halfgaar/BBBAudioDecoderCircuits/bbb_audio_decoder.brd

## EAGLE design bbb_audio_decoder.brd (2020-10-24)

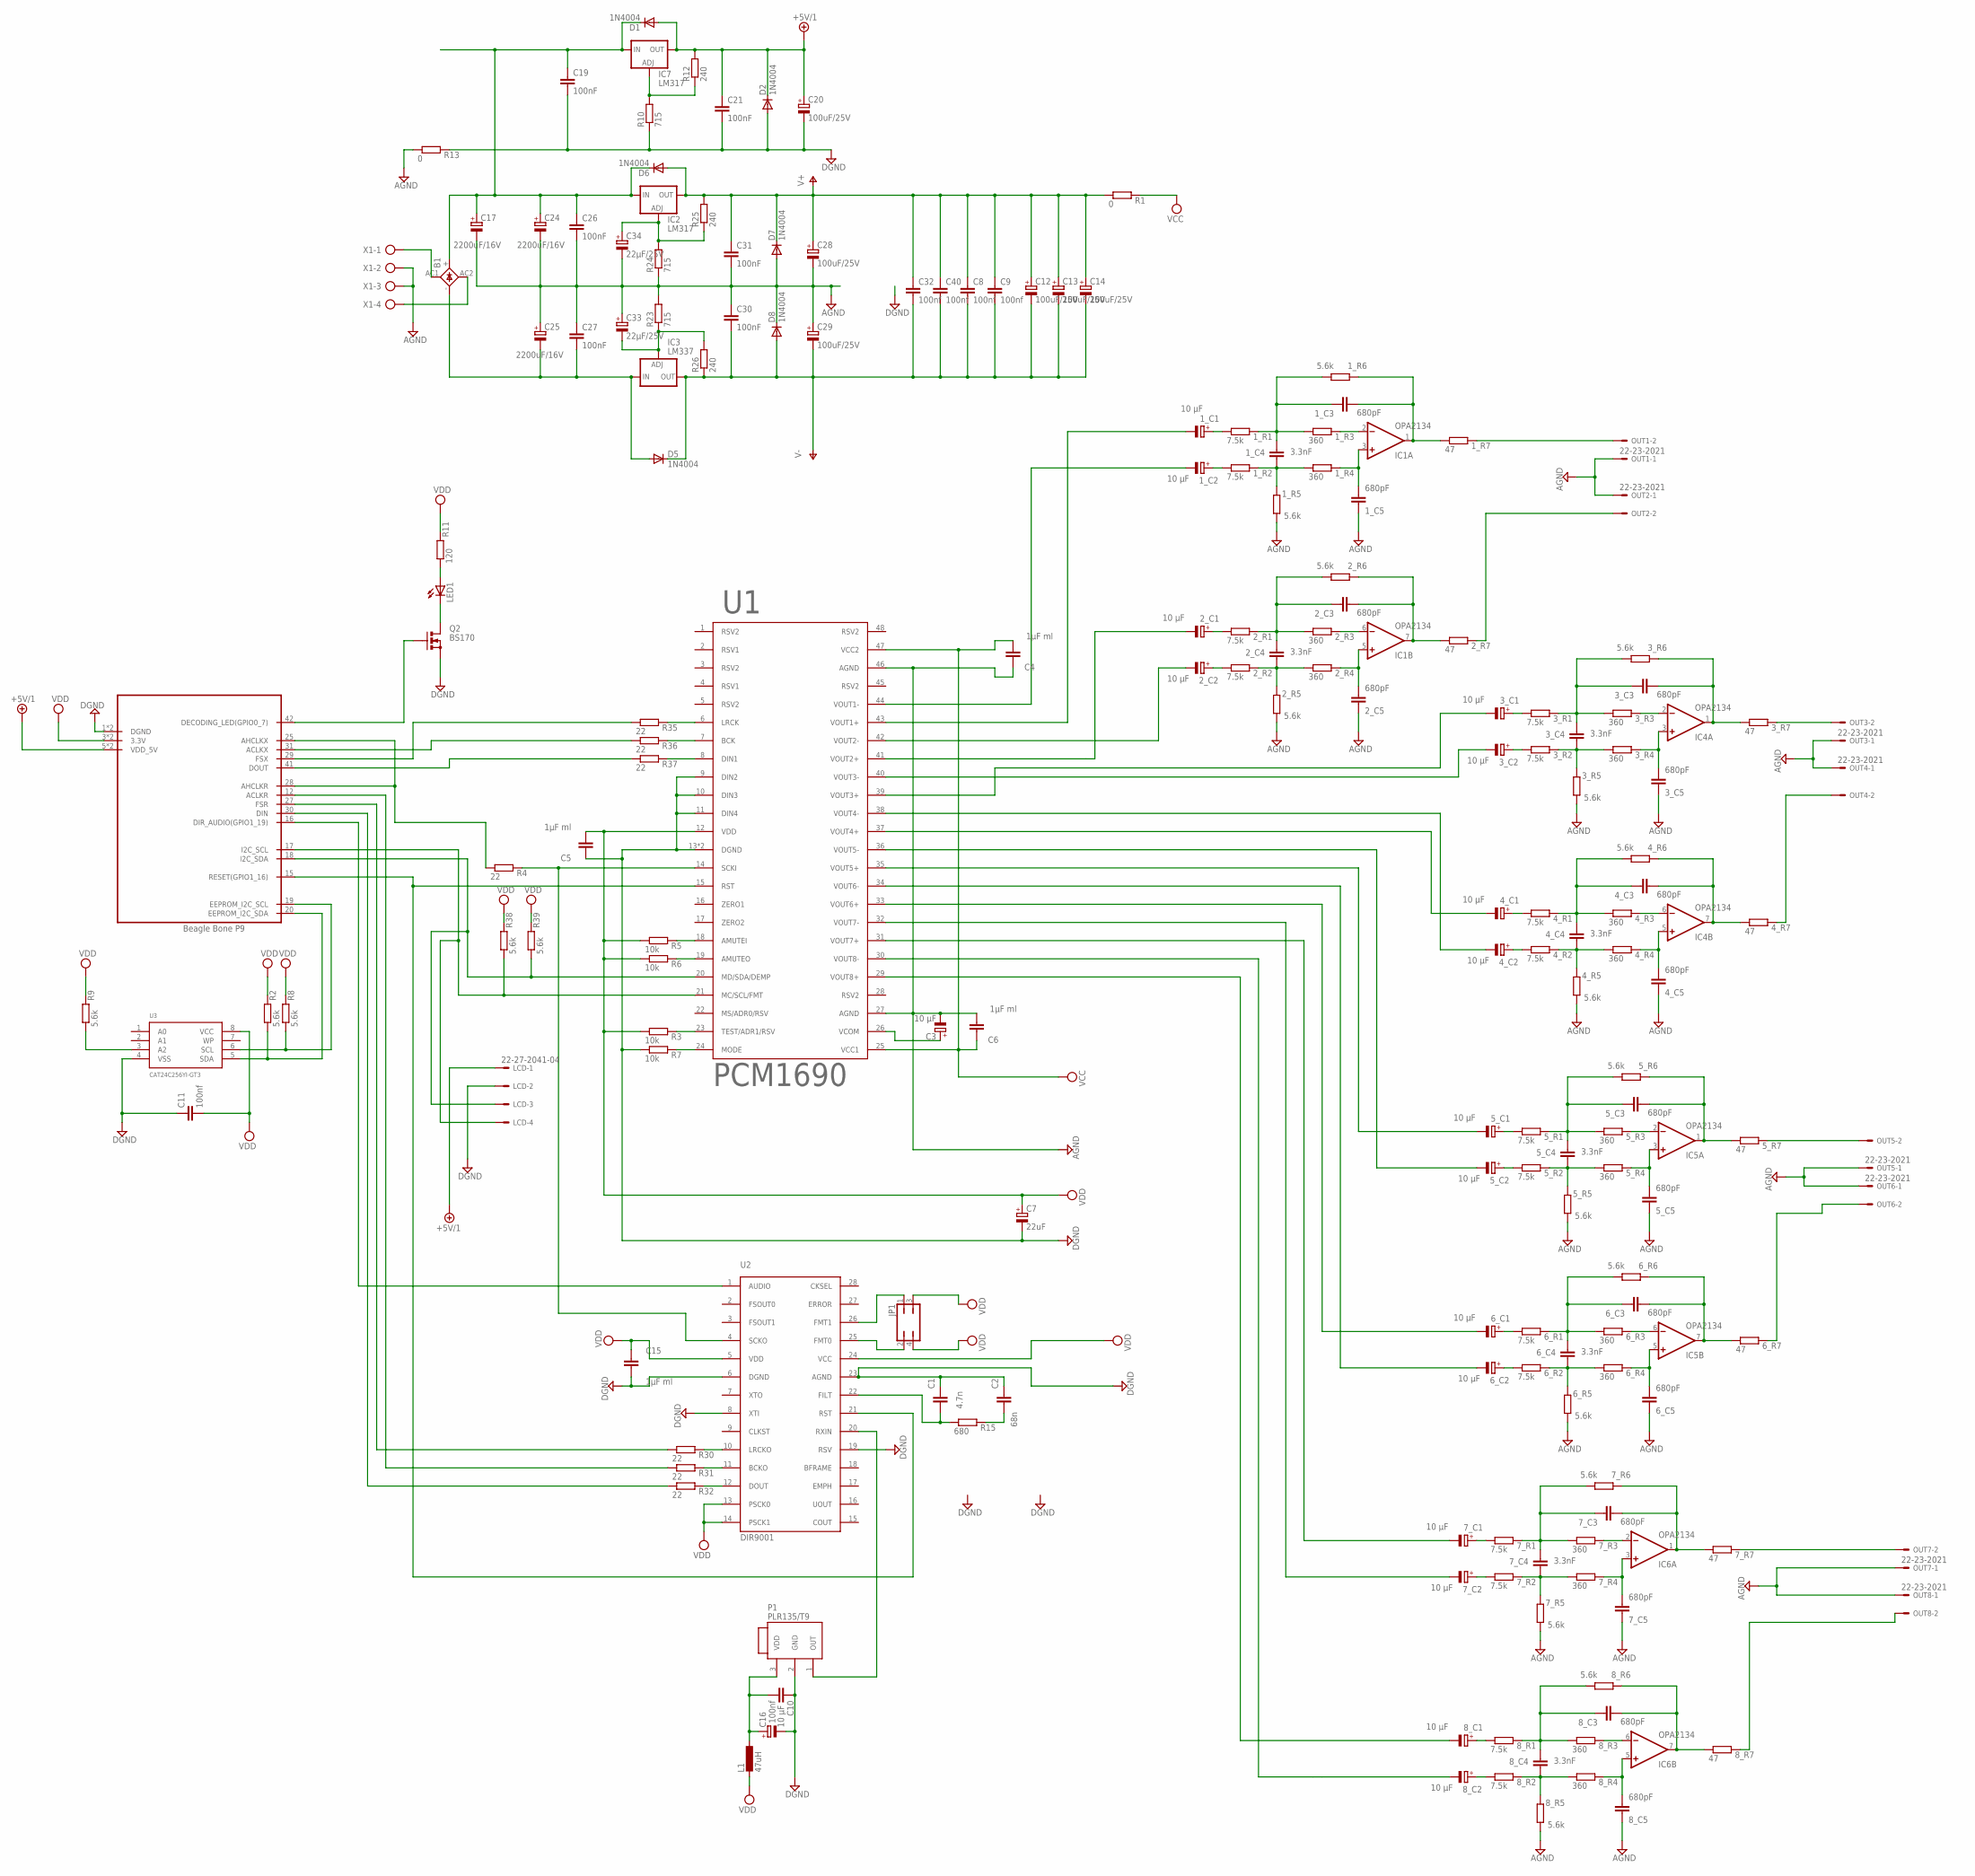
[picture p1: schematic bbb_audio_decoder.sch]

Parts:
1_C1, 1_C2, 2_C1, 2_C2, 3_C1, 3_C2, 4_C1, 4_C2, 5_C1, 5_C2, 6_C1, 6_C2, 7_C1, 7_C2, 8_C1, 8_C2: 10 µF; E2-5
1_C3, 1_C5, 2_C3, 2_C5, 3_C3, 3_C5, 4_C3, 4_C5, 5_C3, 5_C5, 6_C3, 6_C5, 7_C3, 7_C5, 8_C3, 8_C5: 680pF; C050-024X044
1_C4, 2_C4, 3_C4, 4_C4, 5_C4, 6_C4, 7_C4, 8_C4: 3.3nF; C050-025X075
1_R1, 1_R2, 2_R1, 2_R2, 3_R1, 3_R2, 4_R1, 4_R2, 5_R1, 5_R2, 6_R1, 6_R2, 7_R1, 7_R2, 8_R1, 8_R2: 7.5k; 0207/7
1_R3, 1_R4, 2_R3, 2_R4, 3_R3, 3_R4, 4_R3, 4_R4, 5_R3, 5_R4, 6_R3, 6_R4, 7_R3, 7_R4, 8_R3, 8_R4: 360; 0207/7
1_R5, 1_R6, 2_R5, 2_R6, 3_R5, 3_R6, 4_R5, 4_R6, 5_R5, 5_R6, 6_R5, 6_R6, 7_R5, 7_R6, 8_R5, 8_R6: 5.6k; 0207/7
1_R7, 2_R7, 3_R7, 4_R7, 5_R7, 6_R7, 7_R7, 8_R7: 47; 0207/7
B1: FB15
C1: 4.7n; C050-024X044
C2: 68n; C050-024X044
C3, C16: 10 µF; E2-5
C4, C5, C6, C15: 1µF ml; C050-024X044
C7: 22uF; E2-5
C8, C9, C10, C11, C32, C40: 100nf; C050-024X044
C12, C13, C14, C20, C28, C29: 100uF/25V; E2,5-6
C17, C24, C25: 2200uF/16V; E5-13
C19, C21, C26, C27, C30, C31: 100nF; C050-024X044
C33, C34: 22µF/25V; E2,5-6
D1, D2, D5, D6, D7, D8: 1N4004; DO41-7.6
IC1, IC4, IC5, IC6: OPA2134; DIL8
IC2, IC7: LM317; 317TS
IC3: LM337; 337TS
JP1: JP2Q
L1: 47uH; 0207/10
LCD: 22-27-2041-04; 6410-04
LED1: LEDSMT1206; 1206
OUT1, OUT2, OUT3, OUT4, OUT5, OUT6, OUT7, OUT8: 22-23-2021
P1: PLR135/T9
Q2: BS170; SOT54E
R1, R13: 0; 0204V
R2, R8, R9, R38, R39: 5.6k; 0207/7
R3, R5, R6, R7: 10k; 0207/7
R4, R30, R31, R32, R35, R36, R37: 22; 0207/7
R10, R23: 715; 0204V
R11: 120; 0204V
R12, R25, R26: 240; 0204V
R15: 680; 0207/7
R24: 715; 0207/10
U1: PCM1690; HTSSOP48DFD
U2: DIR9001; TSSOP28
U3: CAT24C256YI-GT3; TSSOP8
U$1: BEAGLEBONEP9; HEADERS23-2
X1: AK500/4

Connections:
ACLKR: R31.1, U$1.12 (ACLKR)
ACLKX: R36.1, U$1.31 (ACLKX)
AGND: 1_C5.1, 1_R5.1, 2_C5.1, 2_R5.1, 3_C5.1, 3_R5.1, 4_C5.1, 4_R5.1, 5_C5.1, 5_R5.1, 6_C5.1, 6_R5.1, 7_C5.1, 7_R5.1, 8_C5.1, 8_R5.1, C3.-, C4.1, C6.2, C17.-, C24.-, C25.+, C26.2, C27.1, C28.-, C29.+, C30.1, C31.2, C33.+, C34.-, D7.A, D8.C, OUT1.1, OUT2.1, OUT3.1, OUT4.1, OUT5.1, OUT6.1, OUT7.1, OUT8.1, R13.1, R23.2, R24.1, U1.27 (AGND), U1.46 (AGND), X1.2, X1.3
CAPE_I2C_SCL: R8.1, U3.6 (SCL), U$1.19 (EEPROM_I2C_SCL)
CAPE_I2C_SDA: R2.1, U3.5 (SDA), U$1.20 (EEPROM_I2C_SDA)
DGND: C1.1, C2.1, C5.1, C7.-, C10.1, C11.1, C15.2, C16.-, C19.2, C20.-, C21.2, D2.A, LCD.2, P1.2 (GND), Q2.S, R7.1, R10.1, R13.2, U1.9 (DIN2), U1.10 (DIN3), U1.11 (DIN4), U1.13 (DGND), U1.EXP (DGND), U2.6 (DGND), U2.8 (XTI), U2.19 (RSV), U2.23 (AGND), U3.4 (VSS), U$1.1 (DGND), U$1.2 (DGND)
DIN: R32.1, U$1.30 (DIN)
DIR_AUDIO: U2.1 (AUDIO), U$1.16 (DIR_AUDIO(GPIO1_19))
DOUT: R37.1, U$1.41 (DOUT)
FILT: C1.2, R15.1, U2.22 (FILT)
FSR: R30.1, U$1.27 (FSR)
FSX: R35.1, U$1.29 (FSX)
MCLK: R4.1, U$1.25 (AHCLKX), U$1.28 (AHCLKR)
unnamed: B1.AC2, X1.4
unnamed: R3.2, U1.23 (TEST/ADR1/RSV)
unnamed: B1.AC1, X1.1
unnamed: LED1.A, R11.1
unnamed: R4.2, U1.14 (SCKI), U2.4 (SCKO)
unnamed: C2.2, R15.2
unnamed: JP1.2, U2.25 (FMT0)
unnamed: JP1.1, U2.26 (FMT1)
unnamed: 3_C4.1, 3_R2.2, 3_R4.1, 3_R5.2
unnamed: 3_C3.1, 3_C4.2, 3_R1.2, 3_R3.1, 3_R6.1
unnamed: R5.2, U1.18 (AMUTEI)
unnamed: C10.2, C16.+, L1.1, P1.3 (VDD)
unnamed: 1_C4.1, 1_R2.2, 1_R4.1, 1_R5.2
unnamed: 2_C4.1, 2_R2.2, 2_R4.1, 2_R5.2
unnamed: 2_C3.1, 2_C4.2, 2_R1.2, 2_R3.1, 2_R6.1
unnamed: 3_C5.2, 3_R4.2, IC4.3 (+IN)
unnamed: R6.2, U1.19 (AMUTEO)
unnamed: 1_C3.1, 1_C4.2, 1_R1.2, 1_R3.1, 1_R6.1
unnamed: R7.2, U1.24 (MODE)
unnamed: P1.1 (OUT), U2.20 (RXIN)
unnamed: 3_C3.2, 3_R6.2, 3_R7.1, IC4.1 (OUT)
unnamed: 3_R3.2, IC4.2 (-IN)
unnamed: 1_R3.2, IC1.2 (-IN)
unnamed: 1_C5.2, 1_R4.2, IC1.3 (+IN)
unnamed: 1_C2.+, 1_R2.1
unnamed: 1_C3.2, 1_R6.2, 1_R7.1, IC1.1 (OUT)
unnamed: 1_C1.+, 1_R1.1
unnamed: LED1.C, Q2.D
unnamed: 7_C4.1, 7_R2.2, 7_R4.1, 7_R5.2
unnamed: 2_C5.2, 2_R4.2, IC1.5 (+IN)
unnamed: 2_C3.2, 2_R6.2, 2_R7.1, IC1.7 (OUT)
unnamed: 2_R3.2, IC1.6 (-IN)
unnamed: 2_C2.+, 2_R2.1
unnamed: 2_C1.+, 2_R1.1
unnamed: 7_C3.1, 7_C4.2, 7_R1.2, 7_R3.1, 7_R6.1
unnamed: 7_C5.2, 7_R4.2, IC6.3 (+IN)
unnamed: 1_R7.2, OUT1.2
unnamed: 2_R7.2, OUT2.2
unnamed: B1.+, C17.+, C19.1, C24.+, C26.1, D1.C, D6.C, IC2.3 (IN), IC7.3 (IN)
unnamed: IC7.1 (ADJ), R10.2, R12.1
unnamed: B1.-, C25.-, C27.2, D5.A, IC3.2 (IN)
unnamed: C33.-, IC3.1 (ADJ), R23.1, R26.2
unnamed: C34.+, IC2.1 (ADJ), R24.2, R25.1
unnamed: 3_C2.+, 3_R2.1
unnamed: 3_C1.+, 3_R1.1
unnamed: 7_C3.2, 7_R6.2, 7_R7.1, IC6.1 (OUT)
unnamed: 7_R3.2, IC6.2 (-IN)
unnamed: 4_C4.1, 4_R2.2, 4_R4.1, 4_R5.2
unnamed: 4_C3.1, 4_C4.2, 4_R1.2, 4_R3.1, 4_R6.1
unnamed: 4_C5.2, 4_R4.2, IC4.5 (+IN)
unnamed: R32.2, U2.12 (DOUT)
unnamed: R31.2, U2.11 (BCKO)
unnamed: R30.2, U2.10 (LRCKO)
unnamed: R9.1, U3.3 (A2)
unnamed: 4_C3.2, 4_R6.2, 4_R7.1, IC4.7 (OUT)
unnamed: 4_R3.2, IC4.6 (-IN)
unnamed: 4_C2.+, 4_R2.1
unnamed: 4_C1.+, 4_R1.1
unnamed: 7_C2.+, 7_R2.1
unnamed: 7_C1.+, 7_R1.1
unnamed: R37.2, U1.8 (DIN1)
unnamed: R36.2, U1.7 (BCK)
unnamed: R35.2, U1.6 (LRCK)
unnamed: 3_R7.2, OUT3.2
unnamed: 4_R7.2, OUT4.2
unnamed: 5_C4.1, 5_R2.2, 5_R4.1, 5_R5.2
unnamed: 5_C3.1, 5_C4.2, 5_R1.2, 5_R3.1, 5_R6.1
unnamed: 5_C5.2, 5_R4.2, IC5.3 (+IN)
unnamed: 5_C3.2, 5_R6.2, 5_R7.1, IC5.1 (OUT)
unnamed: 5_R3.2, IC5.2 (-IN)
unnamed: 5_C2.+, 5_R2.1
unnamed: 5_C1.+, 5_R1.1
unnamed: 8_C4.1, 8_R2.2, 8_R4.1, 8_R5.2
unnamed: 8_C3.1, 8_C4.2, 8_R1.2, 8_R3.1, 8_R6.1
unnamed: 6_C4.1, 6_R2.2, 6_R4.1, 6_R5.2
unnamed: 6_C3.1, 6_C4.2, 6_R1.2, 6_R3.1, 6_R6.1
unnamed: 6_C5.2, 6_R4.2, IC5.5 (+IN)
unnamed: 6_C3.2, 6_R6.2, 6_R7.1, IC5.7 (OUT)
unnamed: 6_R3.2, IC5.6 (-IN)
unnamed: 6_C2.+, 6_R2.1
unnamed: 6_C1.+, 6_R1.1
unnamed: 5_R7.2, OUT5.2
unnamed: 6_R7.2, OUT6.2
unnamed: 8_C5.2, 8_R4.2, IC6.5 (+IN)
unnamed: 8_C3.2, 8_R6.2, 8_R7.1, IC6.7 (OUT)
unnamed: 8_R3.2, IC6.6 (-IN)
unnamed: 8_C2.+, 8_R2.1
unnamed: 8_C1.+, 8_R1.1
unnamed: 7_R7.2, OUT7.2
unnamed: 8_R7.2, OUT8.2
unnamed: Q2.G, U$1.42 (DECODING_LED(GPIO0_7))
RST: U1.15 (RST), U2.21 (RST), U$1.15 (RESET(GPIO1_16))
SCL: LCD.4, R38.1, U1.21 (MC/SCL/FMT), U$1.17 (I2C_SCL)
SDA: LCD.3, R39.1, U1.20 (MD/SDA/DEMP), U$1.18 (I2C_SDA)
V+: C8.1, C9.1, C12.+, C13.+, C14.+, C28.+, C31.1, C32.1, C40.1, D6.A, D7.C, IC1.8 (V+), IC2.2 (OUT), IC4.8 (V+), IC5.8 (V+), IC6.8 (V+), R1.1, R25.2
V-: C8.2, C9.2, C12.-, C13.-, C14.-, C29.-, C30.2, C32.2, C40.2, D5.C, D8.A, IC1.4 (V-), IC3.3 (OUT), IC4.4 (V-), IC5.4 (V-), IC6.4 (V-), R26.1
VCC: C4.2, C6.1, R1.2, U1.25 (VCC1), U1.47 (VCC2)
VCOM: C3.+, U1.26 (VCOM)
VDD: C5.2, C7.+, C11.2, C15.1, JP1.3, JP1.4, L1.2, R2.2, R3.1, R5.1, R6.1, R8.2, R9.2, R11.2, R38.2, R39.2, U1.12 (VDD), U2.5 (VDD), U2.13 (PSCK0), U2.14 (PSCK1), U2.24 (VCC), U3.8 (VCC), U$1.3 (3.3V), U$1.4 (3.3V)
VDD_5V: C20.+, C21.1, D1.A, D2.C, IC7.2 (OUT), LCD.1, R12.2, U$1.5 (VDD_5V), U$1.6 (VDD_5V)
VOUT1+: 1_C1.-, U1.43 (VOUT1+)
VOUT1-: 1_C2.-, U1.44 (VOUT1-)
VOUT2+: 2_C1.-, U1.41 (VOUT2+)
VOUT2-: 2_C2.-, U1.42 (VOUT2-)
VOUT3+: 3_C1.-, U1.39 (VOUT3+)
VOUT3-: 3_C2.-, U1.40 (VOUT3-)
VOUT4+: 4_C1.-, U1.37 (VOUT4+)
VOUT4-: 4_C2.-, U1.38 (VOUT4-)
VOUT5+: 5_C1.-, U1.35 (VOUT5+)
VOUT5-: 5_C2.-, U1.36 (VOUT5-)
VOUT6+: 6_C1.-, U1.33 (VOUT6+)
VOUT6-: 6_C2.-, U1.34 (VOUT6-)
VOUT7+: 7_C1.-, U1.31 (VOUT7+)
VOUT7-: 7_C2.-, U1.32 (VOUT7-)
VOUT8+: 8_C1.-, U1.29 (VOUT8+)
VOUT8-: 8_C2.-, U1.30 (VOUT8-)

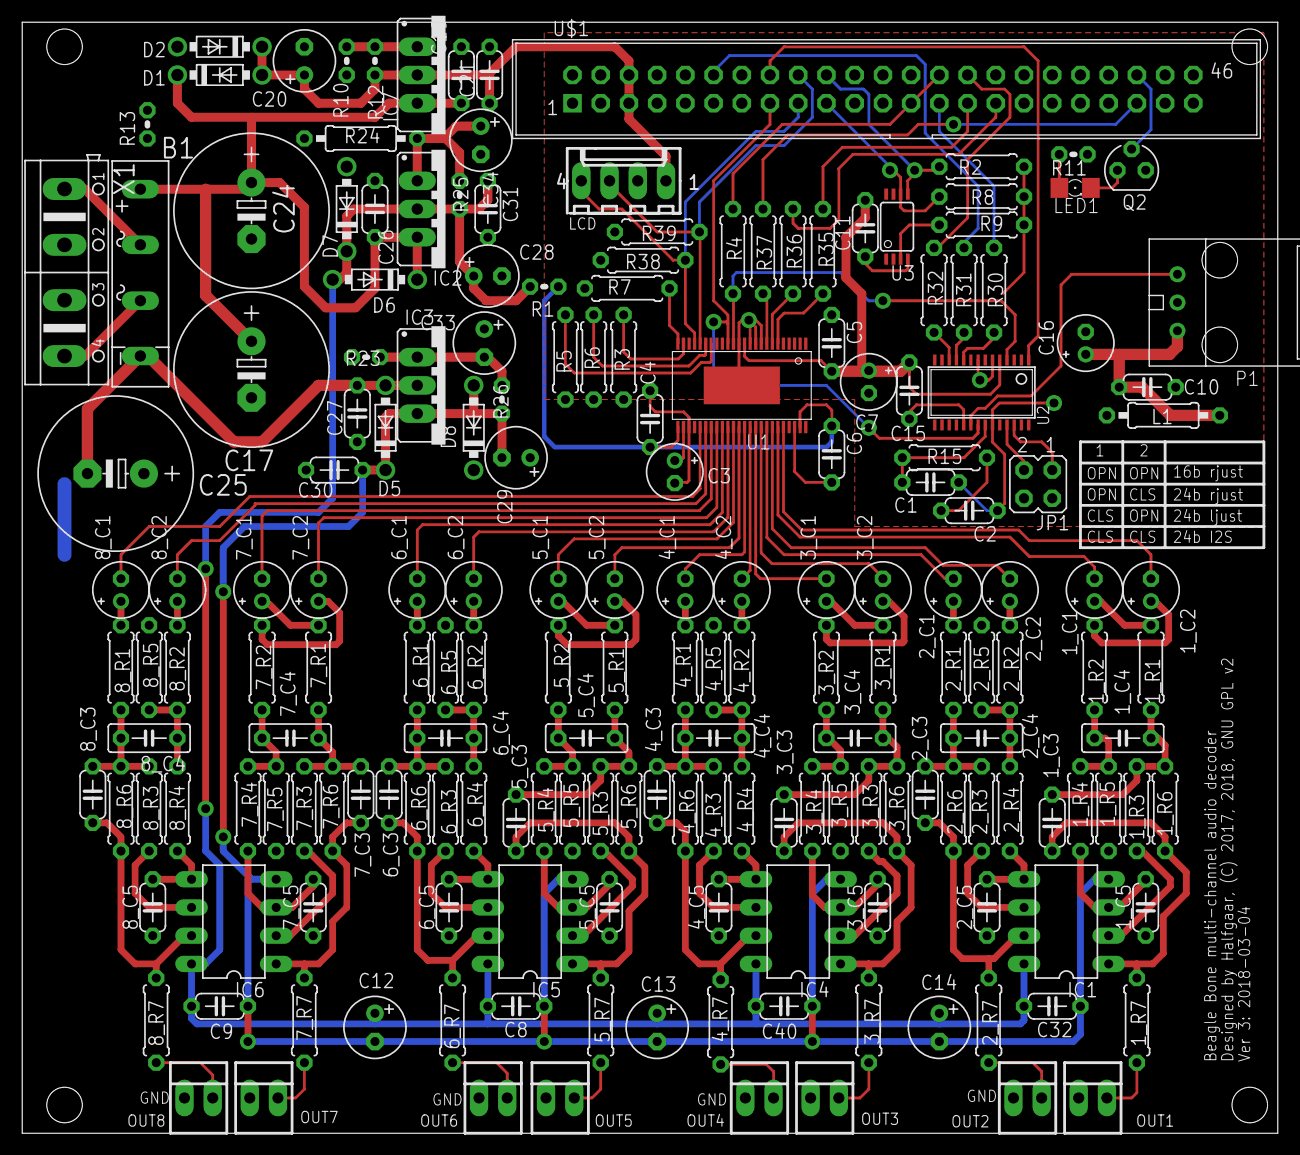
[picture p2: board bbb_audio_decoder.brd from above]

Board: 2 copper layers, 113.0 x 100.0 mm, 187 parts (0 on the bottom side), 129 nets.
