halfgaar/BBBAudioDecoderCircuits/lcd_mounting_board.brd

## EAGLE design lcd_mounting_board.brd (2017-11-06)

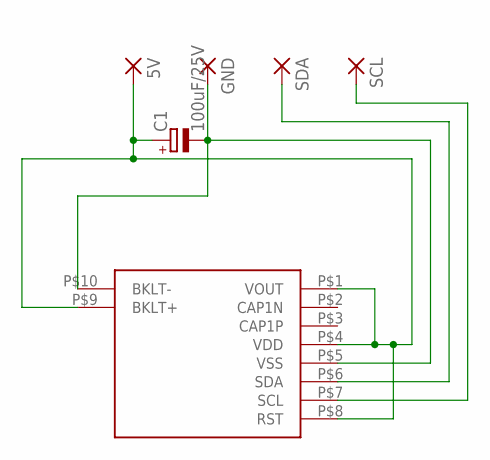
[picture p3: schematic lcd_mounting_board.sch]

Parts:
5V: 2,15/1,0
C1: 100uF/25V; E2,5-6
GND: 2,15/1,0
SCL: 2,15/1,0
SDA: 2,15/1,0
U$1: MCCOG22005A6W-BNMLWI

Connections:
5V: 5V.1, C1.+, U$1.P$1 (VOUT), U$1.P$4 (VDD), U$1.P$8 (RST), U$1.P$9 (BKLT+)
GND: C1.-, GND.1, U$1.P$5 (VSS), U$1.P$10 (BKLT-)
SCL: SCL.1, U$1.P$7 (SCL)
SDA: SDA.1, U$1.P$6 (SDA)

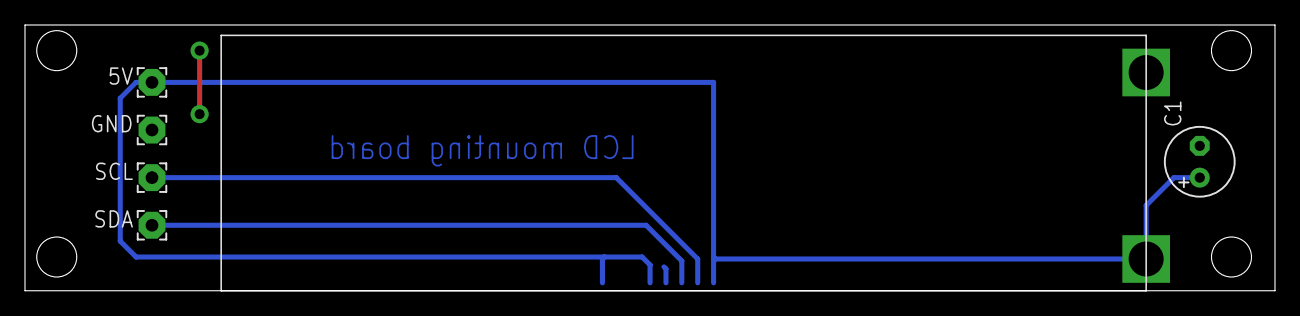
[picture p4: board lcd_mounting_board.brd from above]

Board: 2 copper layers, 100.0 x 21.3 mm, 6 parts (0 on the bottom side), 4 nets.
