halfgaar/BBBAudioDecoderCircuits/(commit log)

2015-06-04 Progressing nicely. Time for a first commit.
    [experimentboard.brd, experimentboard.sch]
2017-01-16 Taking the Beaglebone approach
    [experimentboard.brd, experimentboard.sch]
2017-01-22 Reversed opamp
    Because signals are now on top layer, the layout had to be mirrored.
    [experimentboard.brd, experimentboard.sch]
2017-01-22 Copied two extra output stages
    [experimentboard.brd, experimentboard.sch]
2017-01-22 Added another analog output stage
    [experimentboard.brd, experimentboard.sch]
2017-01-22 Added the last analog output stage
    [experimentboard.brd, experimentboard.sch]
2017-01-27 Working on EEPROM and TOSLINK
    [experimentboard.brd, experimentboard.sch]
2017-01-28 Mostly the analog section, routing and squeezing
    [experimentboard.brd, experimentboard.sch]
2017-01-29 Rotated PSU section, and more work since
    [experimentboard.brd, experimentboard.sch]
2017-02-02 Very nearly done
    I added some power and ground planes and finished more routing.
    Still a bit of decision making to do before I can finish it.
    [experimentboard.brd, experimentboard.sch]
2017-02-02 Fixed 5mm caps, fixed DRC errors
    [experimentboard.brd, experimentboard.sch]
2017-02-06 Added bridge
    [bridge.brd, bridge.sch]
2017-02-06 Added screw holes
    [experimentboard.brd]
2017-02-06 Some moving around for DRC and one tiny airwire
    [experimentboard.brd]
2017-02-06 Approved errors and fixed DIR9001 PIN bug
    [experimentboard.sch]
2017-02-06 Fixed DIR9001 VCC 3.3V misunderstanding
    VCC is actually 3.3V, and AGND is only different from GND in where the
    FILT ties. Almost have that complete. Need to tie the AGND to DGND
    first, and not at a common point with the filter.
    [experimentboard.brd, experimentboard.sch]
2017-02-07 Gave FILT on DIR9001 a dedicated gnd
    [experimentboard.brd]
2017-02-07 Removed unnecessary decoupling cap
    I had added it to decouple VCC to DIR9001, but it didn't even need VCC,
    that was a bug.
    [experimentboard.brd, experimentboard.sch]
2017-02-07 Fixed bug in joining VCC and V+
    I now use a 0 Ohm resistor to join VCC and V+. The jumper is also fixed,
    because I had erroneously tied the PCM1690 VCC to VDD_5V on the beagle
    bone, which means the beagle bone's adapter would have powered the
    PCM1690.
    [experimentboard.brd, experimentboard.sch]
2017-02-07 Removed unnecessary vias
    By moving a bit of wire, the VDD plane is now more continuous.
    [experimentboard.brd]
2017-02-08 Added two status LEDs
    [experimentboard.brd, experimentboard.sch]
2017-02-08 Molex output connectors
    [experimentboard.brd, experimentboard.sch]
2017-02-08 Jumper info on silkscreen
    [experimentboard.brd, experimentboard.sch]
2017-02-08 SCKO selection jumper removed: unneeded
    [experimentboard.brd, experimentboard.sch]
2017-02-08 Version and author info
    [experimentboard.brd]
2017-02-08 Approve more ERC stuff
    [experimentboard.sch]
2017-02-08 Use CAT24C256 with named package suffix
    [experimentboard.brd, experimentboard.sch]
2017-02-09 Changed opamp to value OPA2134
    [experimentboard.brd, experimentboard.sch]
2017-02-09 One more decoupling cap
    [experimentboard.brd, experimentboard.sch]
2017-02-09 Wrote version on board
    [bbb_audio_decoder.brd]
2017-02-19 Made gebers of ver1
    (and snuck in a component value change, because it was a bug and is still
    part of ver1)
    [bbb_audio_decoder.brd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]
2017-02-19 Renamed 5.5 mm adapter symbol
    This one specifies the inner diameter too.
    [bbb_audio_decoder.brd, bbb_audio_decoder.sch]
2017-02-19 Use updated PCM1690 package
    Description was wrong, and the thermal pad wasn't connected.
    [bbb_audio_decoder.brd, bbb_audio_decoder.sch]
2017-02-19 Offset bridge connector
    This is necessary if I want to put the TOSLINK connector right through
    the chassis.
    [bridge.brd]
2017-02-19 Moved C3 and C4 a bit apart
    [bbb_audio_decoder.brd]
2017-02-27 Moved tnames to more legible place
    [bbb_audio_decoder.brd]
2017-02-28 Move the top row of the bridge down a bit
    This makes it fit four times in 10 cm.
    Also made a panelized version of the board.
    [bridge-panelized.brd, bridge.brd]
2017-03-03 Mirrored the offset of the bridge connector
    I made a very stupid mistake and offset it the wrong direction. I
    thought I accounted for the board being upside-down, but I messed up...
    Hours of work down the drain.
    [bridge-panelized.brd, bridge.brd]
2017-05-30 Fix DIR9001 DOUT wrong connection
    It was wired to pin 32 in BBB P9, which is VADC. The correct pin is 30.
    [bbb_audio_decoder.brd, bbb_audio_decoder.sch]
2017-06-25 Fixes wrong net name
    [bbb_audio_decoder.brd, bbb_audio_decoder.sch]
2017-07-24 Use P9 connector with wiring for slave m-clock
    As described from the eaglecustom repo:
    > For my purpose, I need to use an external master clock. This is input on
    > ahclkr, which is pin 28. For that, the previous pin 28 function, axr2,
    > has been moved to axr1, pin 41. And for that, the 'ready' LED that was
    > on pin 41 has been removed.
    [bbb_audio_decoder.brd, bbb_audio_decoder.sch]
2017-07-25 Set DIR9001 SCKO to 512 * Fs
    Both PSCKO pins connect to VDD. I need this to drive 8 channel TDM mode
    in the mcasp in the Beagle Bone.
    [bbb_audio_decoder.brd, bbb_audio_decoder.sch]
2017-09-24 DIR9001 SCKO goes to input of PCM1690 and BBB
    This follows commit c6b4b11003516838945a68f4a9d2063d0b8848d0; we now
    actually connect the master clock.
    [bbb_audio_decoder.brd, bbb_audio_decoder.sch]
2017-10-29 Included LM317 voltage regulator for Beagle Bone
    This is the power supply for it, removing the need for a power adapter
    for it.
    This also changes the AC input to needing a dual winding transformer. My
    idea of univeral adapters was nice, until AC "wall warts" became illegal
    because of energy laws... Plus, I reduced the supply caps, so I need the
    full-wave rectifier now.
    I also removed the jumpers to choose to feed the Beagle Bone from the
    analog power supply. This was an idea that was never going to work, it
    was clear early on. Current demand of one LM317 was too high, and it
    would make the analog supply noisy.
    [bbb_audio_decoder.brd, bbb_audio_decoder.sch]
2017-11-02 Added molex 22-27-2041 connector for LCD
    [bbb_audio_decoder.brd, bbb_audio_decoder.sch]
2017-11-02 Replaced LED with 1206 SMD one
    [bbb_audio_decoder.brd, bbb_audio_decoder.sch]
2017-11-04 Added LCD mounting board
    [lcd_mounting_board.brd, lcd_mounting_board.sch]
2017-11-04 Add ground plane to bridge
    This creates nice 50 Ohm impedance transmission lines (ish).
    [bridge.brd, bridge.sch]
2017-11-04 Added gerbers for ver2
    Also made one final change: a bit of polygon restrict around the screw
    holes, to avoid accendital contact to chassis.
    [bbb_audio_decoder.brd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]
2017-11-06 LCD board, moved everything up a bit, for PCB cutting
    [lcd_mounting_board.brd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]
2018-02-03 Connect DIR9001 SCKO to AHCLKR as well.
    This is a follow-up of commit c6b4b11, where I apparently only connected
    the recovered clock from the DIR9001 to AHCLKX.
    [bbb_audio_decoder.brd, bbb_audio_decoder.sch]
2018-03-04 Separate AGND plane in two, to avoid hum
    The one large ground plane seemed to cause the charging current for the
    main filter caps to circulate around the entire plane, causing the
    signal output ground and circuit ground reference to have different
    potentials, causing a 100 Hz max hum of -75dBV on some outputs.
    This fix breaks the ground plane in two and connects them together with
    a small track, to keep the circuit ground clear of those charging
    currents.
    I wonder if even a 1 Ohm resistor should be used to connect the power
    supply ground plane to the circuit ground plane.
    This fix hasn't been tested at this point, but it's likely what's
    needed.
    In the prototype I fixed the hum by cutting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
    [bbb_audio_decoder.brd]
2018-03-04 GPLv2 license
    [bbb_audio_decoder.brd]
2018-03-04 Version 3
    Gerbers and an update to version number on the silkscreen.
    [bbb_audio_decoder.brd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]
2020-10-24 Add another power supply cap to fix boot problems
    The extra cap (C17) is 2200µF.
    The problem was that it sometimes refused to boot. I saw the
    BeagleBone's blue lights go off again when the boot process was
    initiated. The LCD backlight dipped. Scope image revealved dips in the
    rail, together with 100Hz rectification ripple. As a hack to my build, I
    added 4700µF before the positive regulators. That prevented the
    dips. I'm not sure if this one extra 2200µF is enough though. Probably
    it is, and there are space constraints.
    [bbb_audio_decoder.brd, bbb_audio_decoder.sch]
