halfgaar/BBBAudioDecoderCircuits/(notices)

Notices in the files:
bbb_audio_decoder.brd:
Designed by Halfgaar, (C) 2017, 2018, GNU GPL v2
